wian007/rocket-launcher/stl/pan.stl

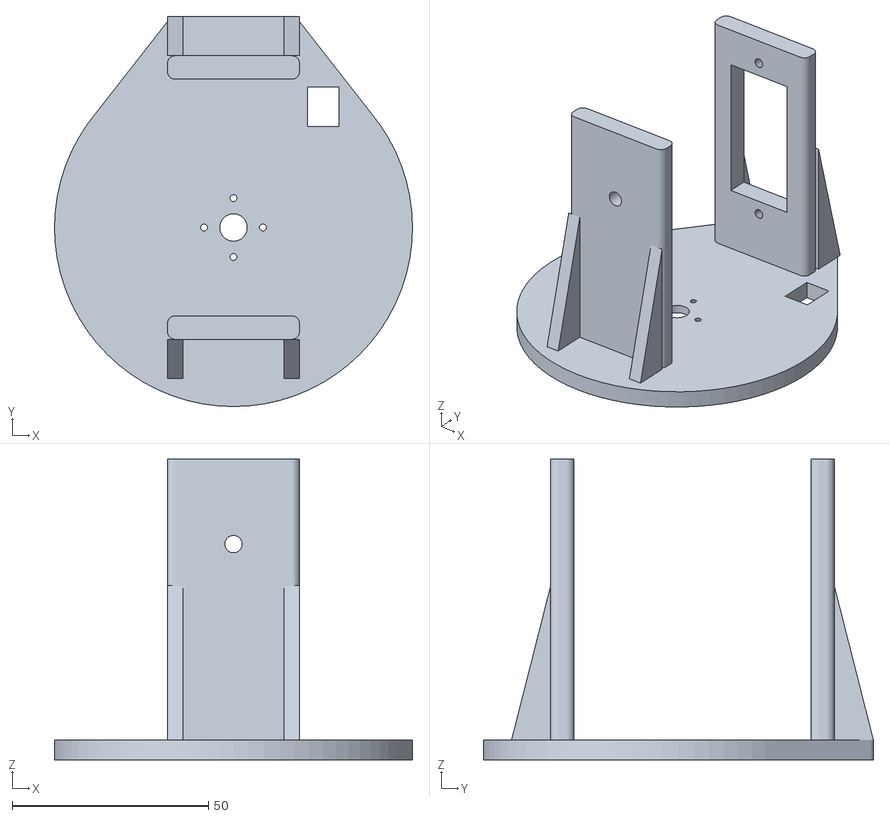
[picture p3: CAD file, 2026-10-24]
stl/pan.stl
91.3 x 99.4 x 76.7
