wian007/rocket-launcher/stl/head_lid.stl

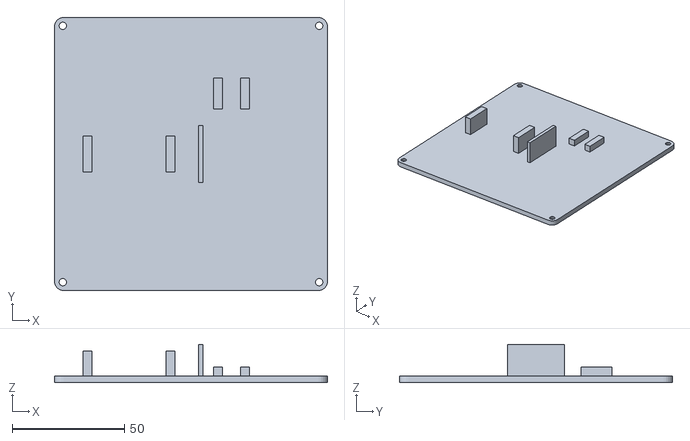
[picture p4: CAD file, 2026-10-24]
stl/head_lid.stl
121.9 x 121.9 x 17.0
