wian007/rocket-launcher/stl/head.stl

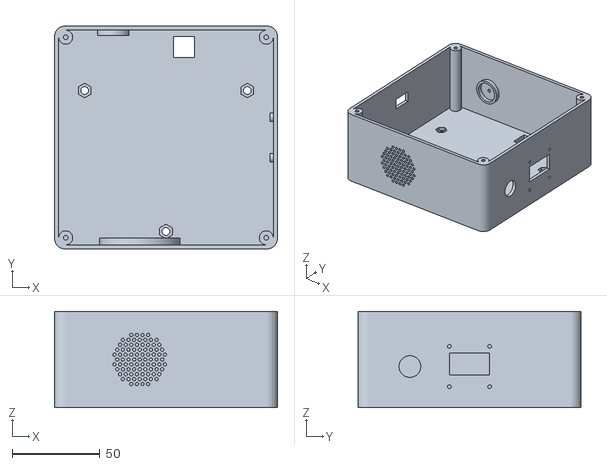
[picture p5: CAD file, 2026-10-24]
stl/head.stl
127.3 x 127.3 x 55.0
