wian007/rocket-launcher/stl/base.stl

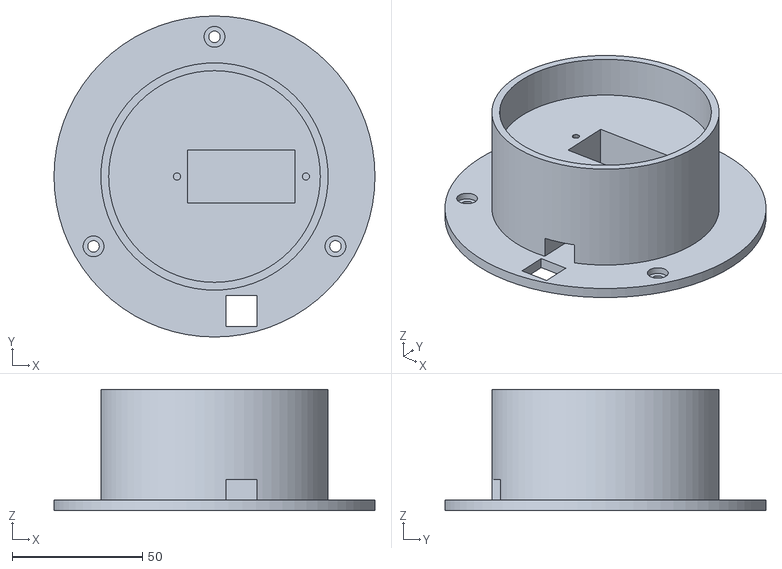
[picture p6: CAD file, 2026-10-24]
stl/base.stl
123.3 x 123.3 x 46.5
