wian007/rocket-launcher/stl/cradle.stl

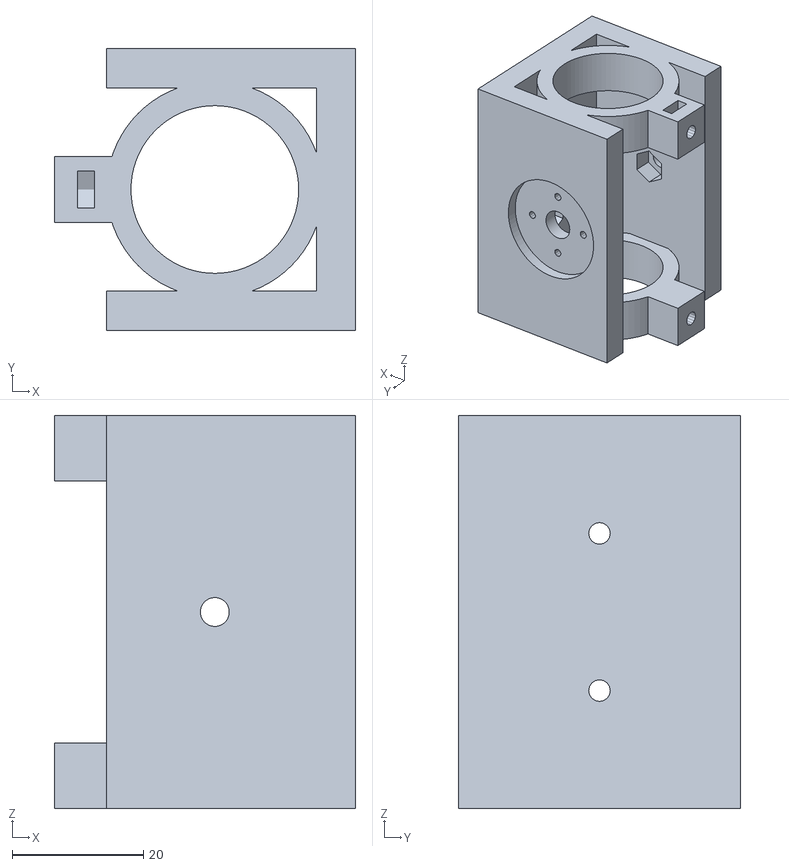
[picture p7: CAD file, 2026-10-24]
stl/cradle.stl
46.0 x 43.0 x 60.0
