wian007/rocket-launcher/stl/camholder.stl

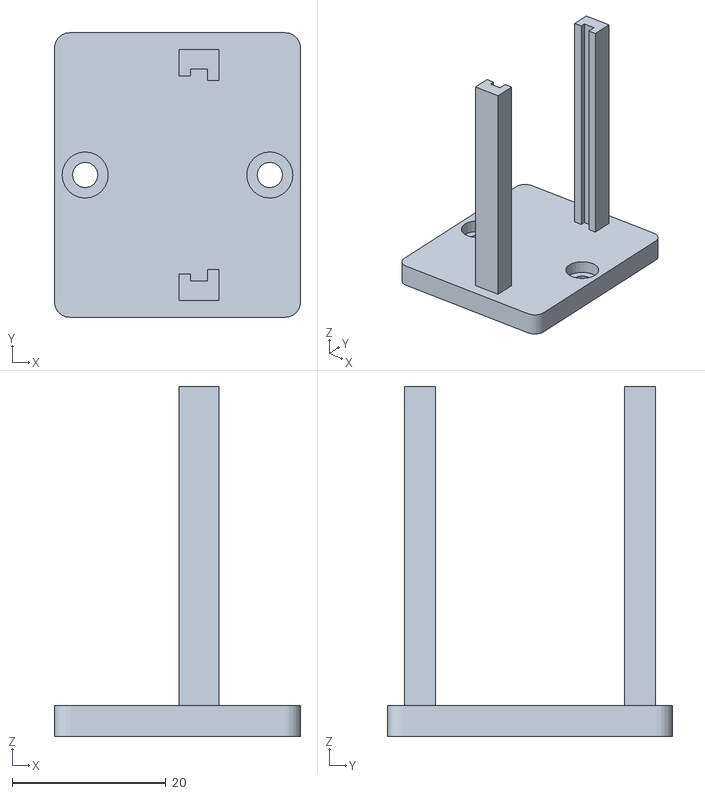
[picture p8: CAD file, 2026-10-24]
stl/camholder.stl
32.0 x 37.0 x 45.5
