wian007/rocket-launcher/voice-face/firmware/head-esp32s3/src/secrets.example.h

// Kopieer naar secrets.h en vul in. secrets.h staat in .gitignore.
#pragma once

#define WIFI_SSID     "jouw-wifi"
#define WIFI_PASSWORD "jouw-wachtwoord"

// IP-adres van de pc/Raspberry Pi waarop bridge.py draait
#define BRIDGE_HOST   "192.168.1.50"
#define BRIDGE_PORT   8765
