wian007/rocket-launcher/(commit log)

2026-10-24 Voeg spraak en OLED-gezicht toe (ESP32-S3-hoofd + spraakbrug)
    ESP32-S3 met INMP441-mic, MAX98357A-versterker, SSD1306/SH1106-OLED en
    praatknop. Python-bridge doet Whisper (NL), Claude met richt-tools (geen
    lanceertool) en Piper-TTS, en streamt audio terug via WebSocket.
    Claude-Session: https://claude.ai/code/session_01G44sbt8NHsGEGinkXT1H95
2026-10-24 Voeg parametrisch pan/tilt-lanceerontwerp toe (OpenSCAD)
    Voet met pan-servo, draaiplateau met juk, kantelwieg die de lanceerbuis
    klemt, ESP32-CAM-houder en een vaste sokkel met OLED-gezicht, praatknop,
    luidspreker en microfoon. Standaard voor MG995, omschakelbaar naar SG90.
    Inclusief geëxporteerde STL's en previews.
    Claude-Session: https://claude.ai/code/session_01AzDvKWTZ6ZcXqsJzSkKxCf
    [base.stl, camholder.stl, cradle.stl, head.stl, head_lid.stl, launcher.scad, pan.stl]
